thrly/midi-foot/(commit log)

2019-03-05 uploading the teensy file via Arduino IDE
2019-03-05 added Max patch for unpacking serial info about buttons
